hexabyte23/QuarkTx/README.md

# QuarkTx, up to 17 Channels !!



Radio Control system based on Arduino Nano ATmega 328  16 Mhz or Teensy 3.2 96 Mhz, with a simple aim: Provide the most powerfull embedded functions in the smalest piece of hardware.

## Doc
Radio [user guide](https://github.com/hexabyte23/QuarkTx/blob/master/Doc/radio.md)

Gui [user guide](https://github.com/hexabyte23/QuarkTx/blob/master/Doc/gui.md)

## Gui dir
Qt client source code for WIN 10, OSX, Android & IOS

## Radio dir
Arduino Nano ATmega328/Teensy 3.2 source code

## RF Module
Two RF modules has been successfully tested: Jeti TU2 2.4 GHz & FrSky DNT.

## RCL: a new language
We introduce RCL, a real time Radio Control Language, that include keywords for reverse, dual rate, exponetial and mixer functions per channel.

The average update rate of channels is more than 900 Hz for a 6 channels config with simple RCL commands.

## Lua

in beta test
