hexabyte23/QuarkTx/Lua/README.md

# Lua library
**Warning**: Only for Teensy 3.2 platform.

Copy of Lua 5.3.2 core functions, must be installed to Arduino IDE library directory :

_Win_: My Documents\Arduino\libraries\

_OSX_: ~/Documents/Arduino/libraries/
