hexabyte23/QuarkTx/Doc/help.pdf

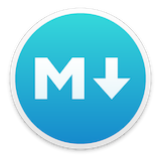
[picture p13: figure]

Hello there! I’m MacDown, the open source Markdown editor for OS X.

Let me introduce myself.

Markdown is a plain text formatting syntax created by John Gruber, aiming to provide a easy-to-read and feasible markup. The original Markdown syntax specification can be found here. (http://daringfireball.net/projects/markdown/syntax)

MacDown is created as a simple-to-use editor for Markdown documents. I render your Markdown contents real-time into HTML, and display them in a preview panel.

# MacDown

# Markdown and I

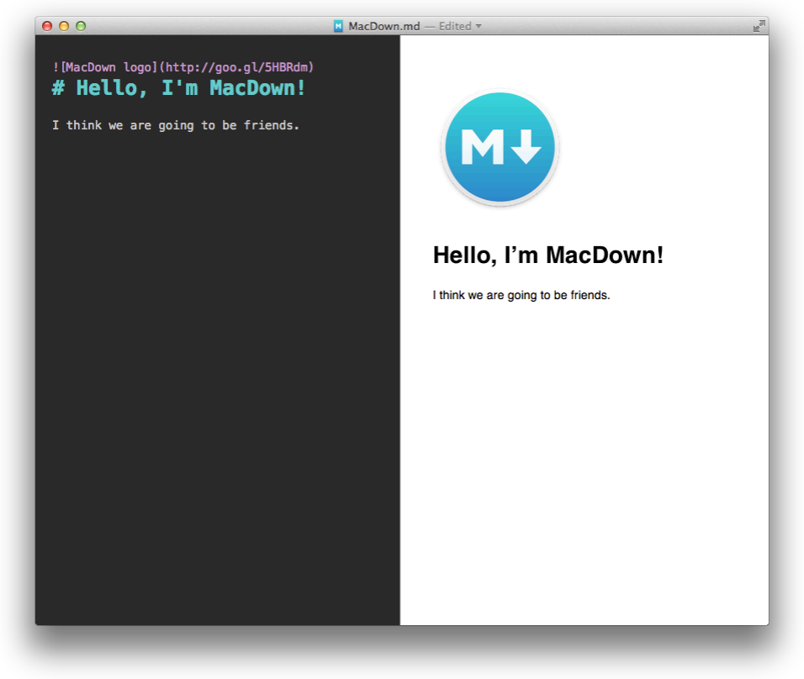
[picture p14: figure]

I support all the original Markdown syntaxes. But I can do so much more! Various popular but non-standard syntaxes can be turned on/off from the Markdown preference pane.

You can specify extra HTML rendering options through the Rendering preference pane.

You can customize the editor window to you liking in the Editor preferences pane:

You can configure various application (that's me!) behaviors in the General preference pane.

Before I tell you about all the extra syntaxes and capabilities I have, I'll introduce you to the basics of standard markdown. If you already know markdown, and want to jump straight to learning about the fancier things I can do, I suggest you skip to the Markdown preference pane. Lets jump right in.

# The Basics

## Line Breaks

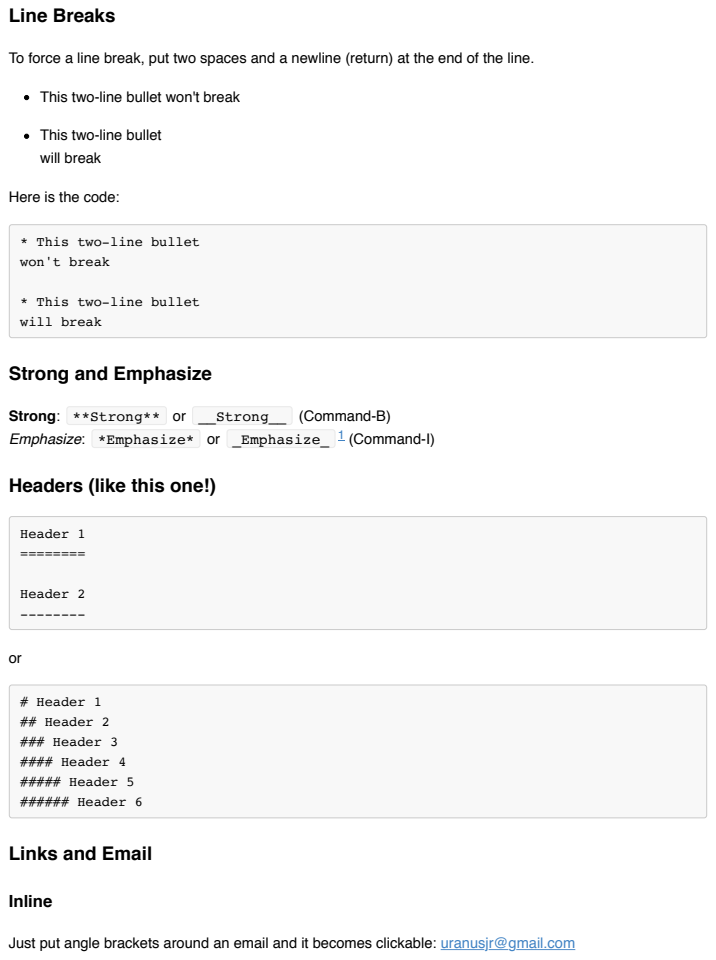
[picture p15: page 3]
Header 1 ========; Header 2 --------; # Header 1 ## Header 2 ### Header 3 #### Header 4 ##### Header 5 ###### Header 6; Inline

To force a line break, put two spaces and a newline (return) at the end of the line.

This two-line bullet won't break

This two-line bullet
will break

Here is the code:

* This two-line bullet
won't break

Strong and Emphasize

Strong: **Strong** or __Strong__ (Command-B)
Emphasize: *Emphasize* or _Emphasize_ 1 (Command-I)

Headers (like this one!)

Links and Email

Just put angle brackets around an email and it becomes clickable: uranusjr@gmail.com

<uranusjr@gmail.com>

Same thing with urls: http://macdown.uranusjr.com<http://macdown.uranusjr.com>

Perhaps you want to some link text like this: Macdown Website (http://macdown.uranusjr.com/)
[Macdown Website](http://macdown.uranusjr.com "Title") (The title is optional)

Sometimes it looks too messy to include big long urls inline, or you want to keep all your urls together.

Make a link (http://macdown.uranusjr.com/) [a link][arbitrary_id] then on it's own line anywhere else in the file: [arbitrary_id]: http://macdown.uranusjr.com "Title"

If the link text itself would make a good id, you can link like this (http://macdown.uranusjr.com/) [like this][] , then on it's own line anywhere else in the file:
[like this]: http://macdown.uranusjr.com

![Alt Image Text](path/or/url/to.jpg "Optional Title")

![Alt Image Text][image-id]
on it's own line elsewhere:
[image-id]: path/or/url/to.jpg "Optional Title"

Lists must be preceded by a blank line (or block element) Unordered lists start each item with a *
- works too

Indent a level to make a nested list
1. Ordered lists are supported.
2. Start each item (number-period-space) like 1.
3. It doesn't matter what number you use, I will render them sequentially
4. So you might want to start each line with 1. and let me sort it out

Here is the code:

### Reference style

## Images

### Inline

### Reference style

## Lists

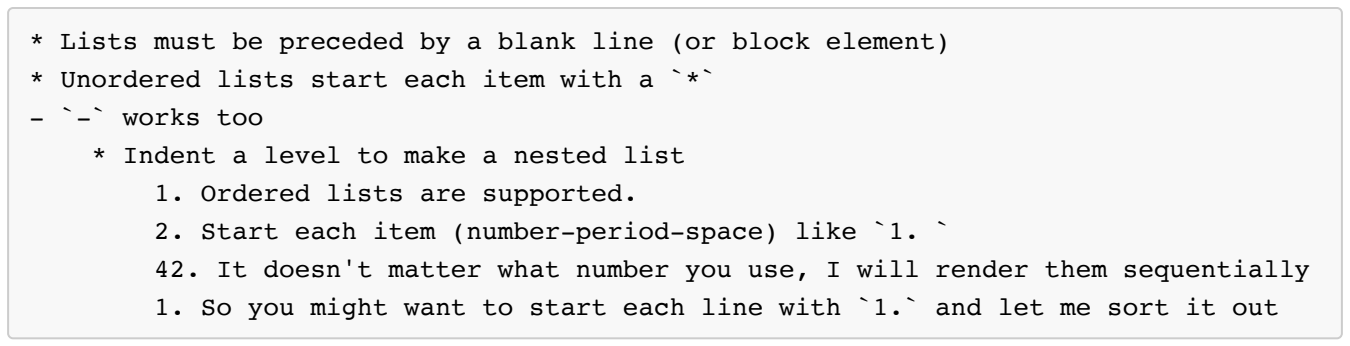
[picture p16: figure]
- `-` works too * Indent a level to make a nested list 1. Ordered lists are supported.

* Lists must be preceded by a blank line (or block element) * Unordered lists start each item with a `*`

2. Start each item (number-period-space) like `1. `
42. It doesn't matter what number you use, I will render them sequentially
1. So you might want to start each line with `1.` and let me sort it out

Angle brackets > are used for block quotes.
Technically not every line needs to start with a > as long as there are no empty lines between paragraphs.
Looks kinda ugly though.

Block quotes can be nested.

Multiple Levels

Most markdown syntaxes work inside block quotes.

Lists
Links (http://macdown.uranusjr.com/)
Etc.

Here is the code:

> Angle brackets `>` are used for block quotes.
Technically not every line needs to start with a `>` as long as there are no empty lines between paragraphs.
> Looks kinda ugly though.
> > Block quotes can be nested.
> > > Multiple Levels
>
> Most markdown syntaxes work inside block quotes. >
> * Lists
> * [Links][arbitrary_id]
> * Etc.

Inline code is indicated by surrounding it with backticks: `Inline code`

## Block Quote

## Inline Code

If your code has `backticks` that need to be displayed, you can use double backticks: ``Code with `backticks` `` (mind the spaces preceding the final set of backticks)

If you indent at least four spaces or one tab, I'll display a code block.

print('The block must be preceded by a blank line')
print('Then indent at least 4 spaces or 1 tab')
print('Nesting does nothing. Your code is displayed Literally')

I also know how to do something called Fenced Code Blocks which I will tell you about later.

If you type three asterisks *** or three dashes --- on a line, I'll display a horizontal rule:

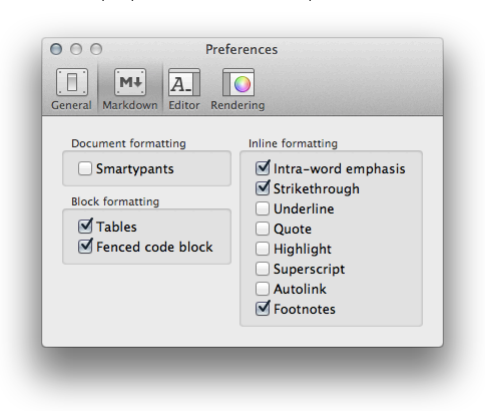
[picture p17: figure]

This is where I keep all preferences related to how I parse markdown into html.

## Block Code

## Horizontal Rules

# The Markdown Preference Pane

The Smartypants extension automatically transforms straight quotes ( " and ' ) in your text into typographer’s quotes ( “ , ” , ‘ , and ’ ) according to the context. Very useful if you’re a typography freak like I am. Quote and Smartypants are syntactically incompatible. If both are enabled, Quote takes precedence.

This is a table:

First Header | Second Header
Content Cell | Content Cell
Content Cell | Content Cell

You can align cell contents with syntax like this:

Left Aligned | Center Aligned | Right Aligned
col 3 is | some wordy text | $1600
col 2 is | centered | $12
zebra stripes | are neat | $1
The left- and right-most pipes ( | ) are only aesthetic, and can be omitted. The spaces don’t matter, either.
Alignment depends solely on : marks.

This is a fenced code block:

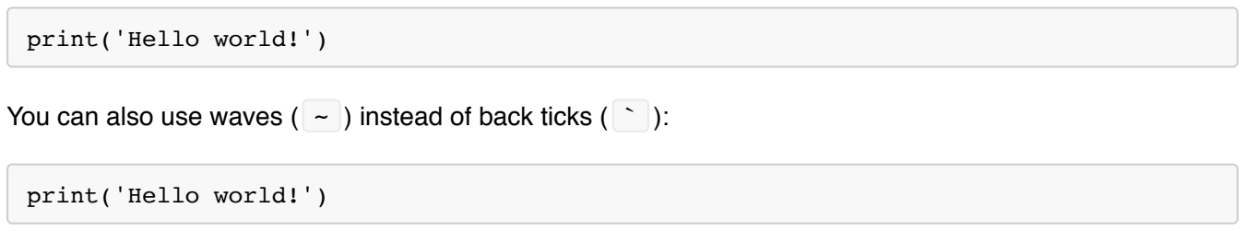
[picture p18: figure]
print('Hello world!')

You can also use waves ( ~ ) instead of back ticks ( ` ):

You can add an optional language ID at the end of the first line. The language ID will only be used to highlight the code inside if you tick the Enable highlighting in code blocks option. This is what happens if

## Document Formatting

## Block Formatting

### Table

### Fenced Code Block

you enable it:

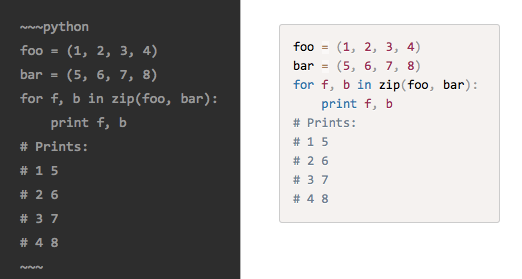
[picture p19: figure]

I support many popular languages as well as some generic syntax descriptions that can be used if your language of choice is not supported. See relevant sections on the official site (http://macdown.uranusjr.com/features/) for a full list of supported syntaxes.

The following is a list of optional inline markups supported:

Option name | Markup | Result if enabled
Intra-word emphasis | So A*maz*ing | So Amazing
Strikethrough | ~~Much wow~~ | Much wow
Underline 2 | _So doge_ | So doge
Quote 3 | "Such editor" | "Such editor"
Highlight | ==So good== | So good
Superscript | hoge^(fuga) | hogefuga
Autolink | http://t.co | http://t.co
Footnotes | [^4] and [^4]: | 4 and footnote 4

This is where I keep preferences relating to how I render and style the parsed markdown in the preview

## Inline Formatting

# The Rendering Preference Pane

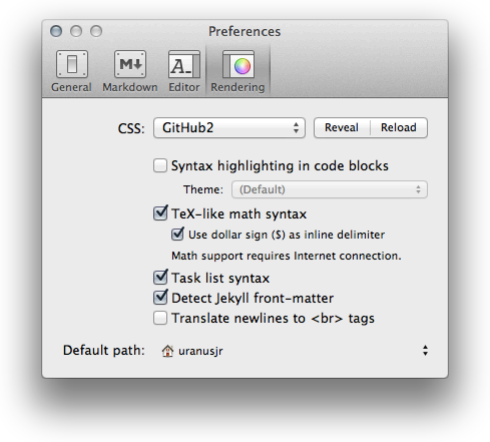
[picture p20: figure]

window.

You can choose different css files for me to use to render your html. You can even customize or add your own custom css files.

You have already seen how I can syntax highlight your fenced code blocks. See the Fenced Code Block section if you haven’t! You can also choose different themes for syntax highlighting.

I can also render TeX-like math syntaxes, if you allow me to.⁵ I can do inline math like this: \( 1 + 1 \) or this (in MathML): 1 + 1, and block math:

\[ A^T_S = B \]

or (in MathML)

## CSS

## Syntax Highlighting

## TeX-like Math Syntax

AS

T = B

1. [x] I can render checkbox list syntax [x] I support nesting
[x] I support ordered and unordered lists
2. [ ] I don't support clicking checkboxes directly in the html window

If you like, I can display Jekyll front-matter in a nice table. Just make sure you put the front-matter at the

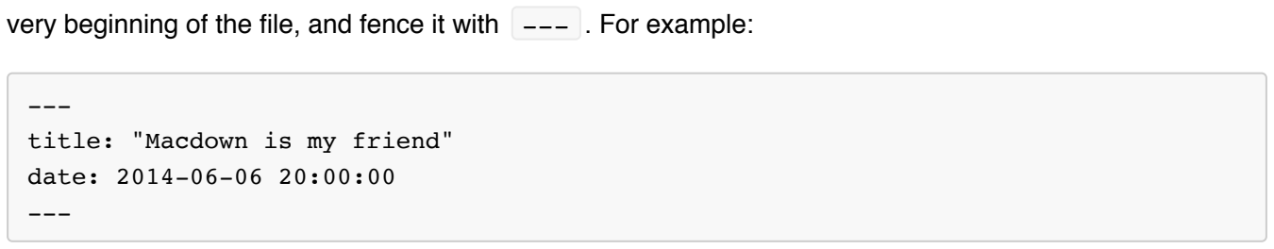
[picture p21: figure]
--- title: "Macdown is my friend" date: 2014-06-06 20:00:00 ---

very beginning of the file, and fence it with --- . For example:

Normally I require you to put two spaces and a newline (aka return) at the end of a line in order to create a line break. If you like, I can render a newline any time you end a line with a newline. However, if you enable this, markdown that looks lovely when I render it might look pretty funky when you let some other program render it.

This is where I keep preferences related to application behavior.

## Task List Syntax

## Jekyll front-matter

## Render newline literally

# The General Preferences Pane

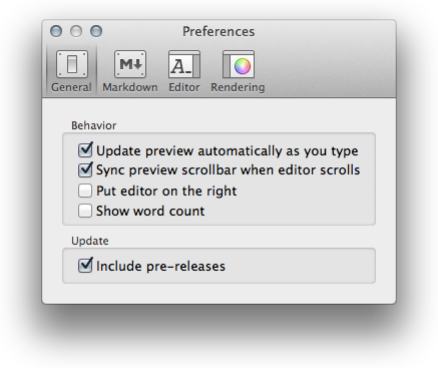
[picture p22: figure]

The General Preferences Pane allows you to tell me how you want me to behave. For example, do you want me to make sure there is a document open when I launch? You can also tell me if I should constantly update the preview window as you type, or wait for you to hit command-R instead. Maybe you prefer your editor window on the right? Or to see the word-count as you type. This is also the place to tell me if you are interested in pre-releases of me, or just want to stick to better-tested official releases.

This is where I keep preferences related to the behavior and styling of the editing window.

# The Editor Preference Pane

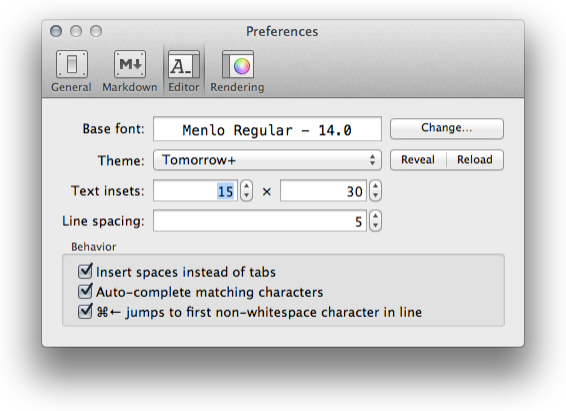
[picture p23: figure]

My editor provides syntax highlighting. You can edit the base font and the coloring/sizing theme. I provided some default themes (courtesy of Mou’s (http://mouapp.com/) creator, Chen Luo) if you don’t know where to start.

You can also edit, or even add new themes if you want to! Just click the Reveal button, and start moving things around. Remember to use the correct file extension ( .styles ), though. I’m picky about that.

I offer auto-completion and other functions to ease your editing experience. If you don’t like it, however, you can turn them off.

That’s about it. Thanks for listening. I’ll be quiet from now on (unless there’s an update about the app—I’ll remind you for that!).

Happy writing!

1. If Underlines is turned on, _this notation_ will render as underlined instead of emphasized ↩
2. If Underline is disabled _this_ will be rendered as emphasized instead of being underlined. ↩

## Styling

# Hack On

3. Quote replaces literal " characters with html <q> tags. Quote and Smartypants are syntactically incompatible. If both are enabled, Quote takes precedence. Note that Quote is different from blockquote, which is part of standard Markdown. ↩
4. You don't have to use a number. Arbitrary things like [^footy note4] and [^footy note4]: will also work. But they will render as numbered footnotes. Also, no need to keep your footnotes in order, I will sort out the order for you so they appear in the same order they were referenced in the text body. You can even keep some footnotes near where you referenced them, and collect others at the bottom of the file in the traditional place for footnotes. ↩
5. Internet connection required. ↩
