hexabyte23/QuarkTx/Artwork/QuarkTx 2.png

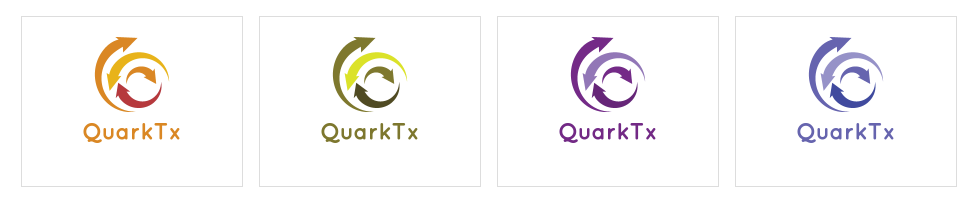
Artwork/QuarkTx 2.png
