hexabyte23/QuarkTx/Artwork/QuarkTx 3.png

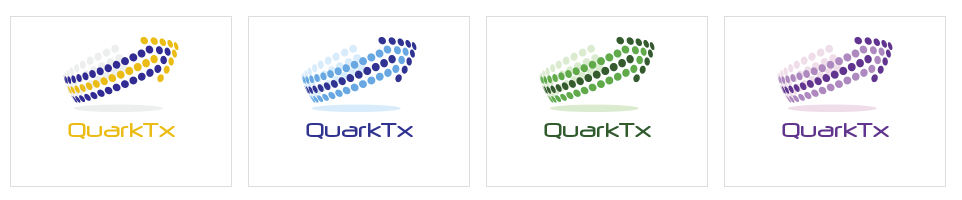
Artwork/QuarkTx 3.png
