hexabyte23/QuarkTx/Artwork/QuarkTx 4.png

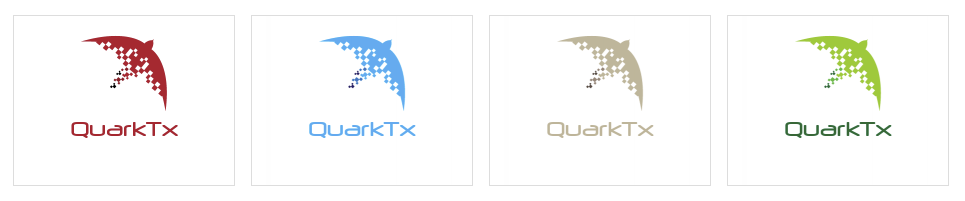
Artwork/QuarkTx 4.png
