hexabyte23/QuarkTx/Artwork/QuarkTx 5.png

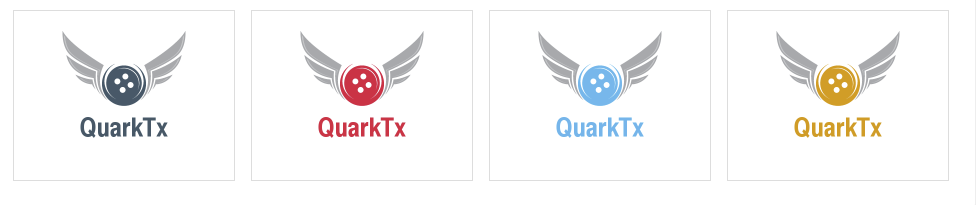
Artwork/QuarkTx 5.png
