hexabyte23/QuarkTx/(threads)

Thread 1 (2015-12-13):

Save sensor calibration result into EEPROM

hexabyte23, 2015-12-13:

hexabyte23, 2015-12-22:
fix done

Closed 2015-12-22.

Thread 2 (2015-12-30):

Bluetooth com unstable

hexabyte23, 2015-12-30:
On Arduino Nano there is only one physical serial port handle by UART.

For conveniant way, we try implement another serial com for bluetooth with SoftwareSerial, but this lib clears interrupt during write() and so make PPM signal glitch...
