hexabyte23/QuarkTx/Radio/Radio.ino

/*
Radio.ino - QuarkTx
Copyright (c) 2015-2018 Thierry & Bertrand WILMOT.  All rights reserved.

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
You should have received a copy of the GNU Lesser General Public
License along with this library; if not, write to the Free Software
Foundation, Inc., 51 Franklin St, Fifth Floor, Boston, MA  02110-1301  USA
*/

#include "Tx.h"

Tx tx;

void setup()
{
  tx.setup();
}

#ifdef QUARKTX_TEENSY
void pit1_isr()
#else
ISR(TIMER1_COMPA_vect)
#endif
{
   tx.onIsrTimerChange();
}


void loop()
{   
   tx.loop();
}
