hexabyte23/QuarkTx/Radio/Sensor.h

/*
Sensor.h - QuarkTx
Copyright (c) 2015-2018 Thierry & Bertrand WILMOT.  All rights reserved.

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
You should have received a copy of the GNU Lesser General Public
License along with this library; if not, write to the Free Software
Foundation, Inc., 51 Franklin St, Fifth Floor, Boston, MA  02110-1301  USA
*/

#ifndef SENSOR_H
#define SENSOR_H

#include <inttypes.h>
#include "config.h"
#ifdef QUARKTX_TEENSY
#include <ArduinoJson.h>
#endif

class Sensor
{
protected:

   uint8_t pin_;
   uint16_t calibrMin_;
   uint16_t calibrMax_;
   int trim_;

   void calibration(uint16_t val);

public:

   Sensor();

   uint8_t getPin() const {return pin_;}
   uint16_t getMinCalibration() const {return calibrMin_;}
   uint16_t getMaxCalibration() const {return calibrMax_;}
   void setTrim(int trim) {trim_ = trim;}
   void setMin(uint16_t calibrMin) {calibrMin_ = calibrMin;}
   void setMax(uint16_t calibrMax) {calibrMax_ = calibrMax;}
   int getTrim() const {return trim_;}

   virtual void dump() const;

   virtual void setup(uint8_t pin) = 0;
   virtual void calibrate() = 0;
   virtual uint16_t getValue() const = 0;
#ifdef QUARKTX_TEENSY
   virtual void saveToJSon(DynamicJsonBuffer &buf) const;
   virtual void loadFfromJSon(const DynamicJsonBuffer &buf);
#endif
   virtual void saveToEEPROM(uint16_t &addr) const;
   virtual void loadFromEEPROM(uint16_t &addr);
   virtual void reset();
};

class Stick : public Sensor
{
public:

   Stick();

   virtual void setup(uint8_t pin);
   virtual void calibrate();
   virtual uint16_t getValue() const;
};

class Switch : public Sensor
{
   void debounce();

public:

   Switch();

   virtual void setup(uint8_t pin);
   virtual void calibrate();
   virtual uint16_t getValue() const;
};

class BatteryMeter : public Sensor
{
   float levelSum_;
   float histoLevel_[BATTERY_HISTO_BUFFER_SIZE];
   uint16_t currentHistoIdx_, oldestHistoIdx_;
   float lastValue_;

   float computeAverageValueInVolt();

public:
   
   BatteryMeter();

   virtual void setup(uint8_t pin);
   virtual void calibrate() {}
   virtual uint16_t getValue() const;
   virtual void reset();
   
   float getValueInVolt() const;
   float getLastAverageValueInVolt() const {return lastValue_;}
   bool isLevelTooLow();
};

class Gyroscope : public Sensor
{
public:

   Gyroscope() {}

   virtual void setup(uint8_t pin);
   virtual void calibrate();
   virtual uint16_t getValue() const;
};

#endif
