hexabyte23/QuarkTx/Radio/Model.cpp

/*
Model.cpp - QuarkTx
Copyright (c) 2015-2018 Thierry & Bertrand WILMOT.  All rights reserved.

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
You should have received a copy of the GNU Lesser General Public
License along with this library; if not, write to the Free Software
Foundation, Inc., 51 Franklin St, Fifth Floor, Boston, MA  02110-1301  USA
*/

#include <arduino.h>
#include <EEPROM.h>
#include "Model.h"
#include "SerialLink.h"

//////////////////////////////////////////////////////////////

ServoCommand::ServoCommand()
{
   reset();
}

uint16_t ServoCommand::getValue(uint16_t rawInputValue) const
{
   uint16_t ret = map(rawInputValue, QUARKTX_ADC_MIN_VALUE, QUARKTX_ADC_MAX_VALUE, isRevert_?maxOutCurse_:minOutCurse_, isRevert_?minOutCurse_:maxOutCurse_) + neutral_;

   // apply PPM bound limitations
   if(ret > QUARKTX_PPM_MAX_VALUE)
      ret = QUARKTX_PPM_MAX_VALUE;
   if(ret < QUARKTX_PPM_MIN_VALUE)
      ret = QUARKTX_PPM_MIN_VALUE;

   return ret;
}

void ServoCommand::reset()
{
   maxOutCurse_ = QUARKTX_PPM_MAX_VALUE;
   minOutCurse_ = QUARKTX_PPM_MIN_VALUE;
   neutral_ = 0;
   isRevert_ = false;
}

void ServoCommand::saveToEEPROM(uint16_t &addr) const
{
   EEPROM.put(addr, maxOutCurse_);
   addr += sizeof(uint16_t);
   EEPROM.put(addr, minOutCurse_);
   addr += sizeof(uint16_t);
   EEPROM.put(addr, neutral_);
   addr += sizeof(int16_t);
   EEPROM.put(addr, isRevert_);
   addr += sizeof(bool);
}

void ServoCommand::loadFromEEPROM(uint16_t &addr)
{
   EEPROM.get(addr, maxOutCurse_);
   addr += sizeof(uint16_t);
   EEPROM.get(addr, minOutCurse_);
   addr += sizeof(uint16_t);
   EEPROM.get(addr, neutral_);
   addr += sizeof(int16_t);
   EEPROM.get(addr, isRevert_);
   addr += sizeof(bool);
}

//////////////////////////////////////////////////////////////

void OutputChannel::saveToEEPROM(uint16_t &addr) const
{
   servo_.saveToEEPROM(addr);
}

void OutputChannel::loadFromEEPROM(uint16_t &addr)
{
   servo_.loadFromEEPROM(addr);
}

//////////////////////////////////////////////////////////////

Model::Model()
{
}

bool Model::setup()
{
   return true;
}

uint16_t Model::getValue(uint8_t channel, uint16_t rawInputValue) const
{
   return channel_[channel].servo_.getValue(rawInputValue);
}

void Model::setMinValue(uint8_t channel, int value)
{
   channel_[channel].servo_.minOutCurse_ = value;
}

void Model::setMaxValue(uint8_t channel, int value)
{
   channel_[channel].servo_.maxOutCurse_ = value;
}

void Model::setNeutralValue(uint8_t channel, uint16_t value)
{
   channel_[channel].servo_.neutral_ = value;
}

void Model::setRevertValue(uint8_t channel, bool value)
{
   channel_[channel].servo_.isRevert_ = value;
}

void Model::dump()
{
#ifndef QUARKTX_TEST
   STDOUT << F("Servo\n# Min   Max   Neutral   Rev") << endl;

   for(int idx=0; idx < QUARKTX_MAX_PPM_OUTPUT_CHANNEL; idx++)
   {
      STDOUT << idx << " " << channel_[idx].servo_.minOutCurse_ << "\t" <<
                channel_[idx].servo_.maxOutCurse_ << "\t" <<
                channel_[idx].servo_.neutral_ << "\t" <<
                channel_[idx].servo_.isRevert_ << endl;
   }
#endif
}

void Model::reset()
{
   for(int idx=0; idx < QUARKTX_MAX_PPM_OUTPUT_CHANNEL; idx++)
      channel_[idx].servo_.reset();
}

void Model::saveToEEPROM(uint16_t &addr) const
{
   for(uint8_t idx=0; idx < QUARKTX_MAX_PPM_OUTPUT_CHANNEL; idx++)
      channel_[idx].saveToEEPROM(addr);
}

void Model::loadFromEEPROM(uint16_t &addr)
{
   for(uint8_t idx=0; idx < QUARKTX_MAX_PPM_OUTPUT_CHANNEL; idx++)
      channel_[idx].loadFromEEPROM(addr);

}
