hexabyte23/QuarkTx/Gui/src/main.cpp

/*
Command.cpp - QuarkTx
Copyright (c) 2015-2016 Thierry & Betrand WILMOT.  All rights reserved.

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
You should have received a copy of the GNU Lesser General Public
License along with this library; if not, write to the Free Software
Foundation, Inc., 51 Franklin St, Fifth Floor, Boston, MA  02110-1301  USA
*/


#include "src/main.h"
#include "src/global.h"
#include "src/BatteryModel.h"
#include "src/MainModel.h"
#include "src/RclMainWindow.h"


Q_LOGGING_CATEGORY(QUARKTX_MAIN, "quarktx.main")

static MainModel g_model;

void myMessageOutput(QtMsgType type, const QMessageLogContext &context, const QString &msg)
{
   QByteArray localMsg = msg.toLocal8Bit();
   const char* time = QTime::currentTime().toString("hh:mm:ss.zzz").toStdString().c_str();
#ifdef QT_DEBUG
   switch (type)
   {
      case QtInfoMsg:
         fprintf(stderr, "%s [I] %s (%s:%u, %s)\n", time, localMsg.constData(), context.file, context.line, context.function);
         break;
      case QtDebugMsg:
         fprintf(stderr, "%s [D] %s (%s:%u, %s)\n", time, localMsg.constData(), context.file, context.line, context.function);
         break;
      case QtWarningMsg:
         fprintf(stderr, "%s [W] %s (%s:%u, %s)\n", time, localMsg.constData(), context.file, context.line, context.function);
         break;
      case QtCriticalMsg:
         fprintf(stderr, "%s [C] %s (%s:%u, %s)\n", time, localMsg.constData(), context.file, context.line, context.function);
         break;
      case QtFatalMsg:
         fprintf(stderr, "%s [F] %s (%s:%u, %s)\n", time, localMsg.constData(), context.file, context.line, context.function);
         abort();
   }
#else
   switch (type)
   {
      case QtInfoMsg:
         fprintf(stderr, "%s [I] %s\n", time, localMsg.constData());
         break;
      case QtDebugMsg:
         break;
      case QtWarningMsg:
         fprintf(stderr, "%s [W] %s\n", time, localMsg.constData());
         break;
      case QtCriticalMsg:
         fprintf(stderr, "%s [C] %s\n", time, localMsg.constData());
         break;
      case QtFatalMsg:
         fprintf(stderr, "%s [F] %s\n", time, localMsg.constData());
         abort();
   }
#endif
}

void Init(const QApplication &app)
{
   qInstallMessageHandler(myMessageOutput);

   QLoggingCategory::setFilterRules(QStringLiteral("quarktx.main=true"));
   QLoggingCategory::setFilterRules(QStringLiteral("*.link=false"));
   QLoggingCategory::setFilterRules(QStringLiteral("quarktx.link.command=true"));

   //app.setFont(QFont("courrier"));
   app.setApplicationName(APP_NAME);
   app.setApplicationVersion(APP_VERSION);
   qCInfo(QUARKTX_MAIN) << "Starting " APP_NAME << APP_VERSION;
}

int main(int argc, char *argv[])
{
   QApplication app(argc, argv);

   Init(app);

   QTranslator qtTranslator;
   QString filename = "QuarkTx_" + QLocale::system().name() + ".qm";
   QString path = ":/";

   // For updating QUARKTX_xx_XX.qm use menu
   // Tools/Extern/linguist/update & lrelease

   if(qtTranslator.load(filename, path) == false)
   {
      QString msg = "'" + path + filename + "' not found";
      qCDebug(QUARKTX_MAIN) << msg;
   }
   else
      app.installTranslator(&qtTranslator);

   QQmlApplicationEngine engine;
   g_model.init(engine.rootContext());
//   engine.load(QUrl(QStringLiteral("qrc:/qml/main.qml")));

   RclMainWindow w;
   w.show();

   int ret = app.exec();

   qCInfo(QUARKTX_MAIN) << "Ending " APP_NAME << APP_VERSION;

   return ret;
}
