hexabyte23/QuarkTx/Gui/src/RadioLink.cpp

/*
Command.cpp - QuarkTx
Copyright (c) 2015-2016 Thierry & Betrand WILMOT.  All rights reserved.

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
You should have received a copy of the GNU Lesser General Public
License along with this library; if not, write to the Free Software
Foundation, Inc., 51 Franklin St, Fifth Floor, Boston, MA  02110-1301  USA
*/

#include "RadioLink.h"
//#include <QThread>

Q_LOGGING_CATEGORY(QUARKTX_LINK_SERIAL, "quarktx.link.serial")
Q_LOGGING_CATEGORY(QUARKTX_LINK_BT, "quarktx.link.bt")

RadioLink::RadioLink()
   :
     isTxConnected_(false),
     transportStatusStr("No transport"),
     cnxStatusStr_("Not connected"),
     txVersionStr_("NA")
#if defined(Q_OS_MAC) || defined(Q_OS_WIN)
     ,serialPort_(NULL),
     serialPortInfo_(NULL)
#endif
{
}

RadioLink::~RadioLink()
{
   closeSerialLink();
   closeBlueToothLink();
}

void RadioLink::closeSerialLink()
{
#if defined(Q_OS_MAC) || defined(Q_OS_WIN)

   if(serialPort_)
   {
      if(serialPort_->isOpen())
         serialPort_->close();
      disconnect(serialPort_, SIGNAL(readyRead()), this, SLOT(serialPortReadyRead()));
      disconnect(serialPort_, SIGNAL(error(QSerialPort::SerialPortError)), this,
                 SLOT(serialPortHandleError(QSerialPort::SerialPortError)));

      delete serialPort_;
      serialPort_ = NULL;

      QSerialPortInfo i;
      serialPortInfo_ = i;
   }
#endif
}

void RadioLink::closeBlueToothLink()
{
}

bool RadioLink::searchForSerialLink()
{
#if defined(Q_OS_MAC) || defined(Q_OS_WIN)

   bool foundCnx = false;
   output_.clear();

   QList<QSerialPortInfo> serialPortInfoList = QSerialPortInfo::availablePorts();
   for (int i = 0; i < serialPortInfoList.size(); i++)
   {
      const QSerialPortInfo &serialPortInfo = serialPortInfoList[i];
      serialPort_ = new QSerialPort(serialPortInfo, this);
      connect(serialPort_, SIGNAL(readyRead()), this, SLOT(serialPortReadyRead()));
      connect(serialPort_, SIGNAL(error(QSerialPort::SerialPortError)), this,
              SLOT(serialPortHandleError(QSerialPort::SerialPortError)));

      qCDebug(QUARKTX_LINK_SERIAL) << "Try open cnx: " << serialPortInfo.portName();

      if(serialPort_->open(QIODevice::ReadWrite))
      {
         qCDebug(QUARKTX_LINK_SERIAL) << "Waiting for anwser...";

         if(serialPort_->waitForReadyRead(QUARKTX_MIN_WAIT_DEVICE))
         {
            qCDebug(QUARKTX_LINK_SERIAL) << "Anwsering... Check if QuarkTx device";

            QString line = getNextLine();
            qCDebug(QUARKTX_LINK_SERIAL) << "Answer is:" << line;

            if(line.startsWith("Quark Tx v"))
            {
               qCDebug(QUARKTX_LINK_SERIAL) << "QuarkTx device detected " << txVersionStr_;

               txVersionStr_ = line.mid(sizeof("Quark Tx v")-1);
               foundCnx = true;
               serialPortInfo_ = serialPortInfo;
               break;
            }
            else
               qCWarning(QUARKTX_LINK_SERIAL) << "Not a QuartTx device";
         }
         else
            qCDebug(QUARKTX_LINK_SERIAL) << "Device not anwsering since 3 sec";

         qCDebug(QUARKTX_LINK_SERIAL) << "Close cnx: " << serialPortInfo.portName();
         closeSerialLink();
      }
      else
      {
         qCWarning(QUARKTX_LINK_SERIAL) << "Fail to open: " << serialPortInfo.portName();
      }
   }

   if(!foundCnx)
   {
      qCWarning(QUARKTX_LINK_SERIAL) << "No QuarkTx device found on serial link";
      return false;
   }

   isTxConnected_ = true;
   transportStatusStr = "Serial link";
   cnxStatusStr_ = serialPortInfo_.portName();

   output_.clear();

   return true;
#else
   return false;
#endif
}

bool RadioLink::searchForBlueToothLink()
{
   return false;
}

void RadioLink::init()
{
}

bool RadioLink::writeData(const QByteArray &data)
{
#if defined(Q_OS_MAC) || defined(Q_OS_WIN)
   if(serialPort_ == NULL)
   {
      qCWarning(QUARKTX_LINK_SERIAL) << "Cnx not established";
      return false;
   }

   input_ = data;
   if(serialPort_->write(data) != -1)
   {
      qCDebug(QUARKTX_LINK_SERIAL) << "< " << data;
      return true;
   }
#endif

   return false;
}

const QByteArray RadioLink::readData()
{
   QByteArray ret;

#if defined(Q_OS_MAC) || defined(Q_OS_WIN)
   if(serialPort_ == NULL)
   {
      qCWarning(QUARKTX_LINK_SERIAL) << "Cnx not established";
      return ret;
   }

   ret = serialPort_->readAll();
   if(ret[0] == '\0')
      ret.remove(0, 1);

   output_ += ret;
#endif

   return ret;
}


// QML functions

bool RadioLink::findTxAndConnect()
{ 
   if(!searchForSerialLink())
   {
      if(!searchForBlueToothLink())
      {
         qCWarning(QUARKTX_LINK_SERIAL) << "No device found";
         return false;
      }
   }

   return true;
}

void RadioLink::txDisconnect()
{
   closeSerialLink();
   closeBlueToothLink();

   isTxConnected_ = false;
   transportStatusStr = "No transport";
   cnxStatusStr_ = "Not connected";
   txVersionStr_ = "NA";

   qCDebug(QUARKTX_LINK_SERIAL) << "Disconnect Tx";
}

QString RadioLink::getNextLine()
{
   QString ret;

#if defined(Q_OS_MAC) || defined(Q_OS_WIN)
   if(serialPort_ == NULL)
   {
      qCWarning(QUARKTX_LINK_SERIAL) << "Cnx not established";
      return ret;
   }

   while(1)
   {
      if(output_.isEmpty())
         serialPort_->waitForReadyRead(-1);

      char c = output_[0];
      output_.remove(0,1);

      if(c == '\r')
         continue;
      else if(c == '\n')
         break;

      ret.append(c);
   }
#endif

   return ret;
}

bool RadioLink::sendCommand(const QString &cmd)
{
   output_.clear();
   return writeData(cmd.toLatin1());
}

// Callbacks

#if defined(Q_OS_MAC) || defined(Q_OS_WIN)

void RadioLink::serialPortReadyRead()
{
   qCDebug(QUARKTX_LINK_SERIAL) << "> " << readData();
}

void RadioLink::serialPortHandleError(QSerialPort::SerialPortError error)
{
   if(serialPort_ == NULL)
   {
      qCWarning(QUARKTX_LINK_SERIAL) << "Cnx not established";
      return;
   }

   if(error != QSerialPort::NoError)
   {
      cnxStatusStr_ = serialPort_->errorString();
      transportStatusStr = "Error";

      qCWarning(QUARKTX_LINK_SERIAL) << "Cnx error: '" << error << "' " << cnxStatusStr_;
   }
}

#endif
