hexabyte23/QuarkTx/Gui/src/TxCommand.cpp

/*
Command.cpp - QuarkTx
Copyright (c) 2015-2016 Thierry & Betrand WILMOT.  All rights reserved.

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
You should have received a copy of the GNU Lesser General Public
License along with this library; if not, write to the Free Software
Foundation, Inc., 51 Franklin St, Fifth Floor, Boston, MA  02110-1301  USA
*/

#include "TxCommand.h"

Q_LOGGING_CATEGORY(QUARKTX_LINK_COMMAND, "quarktx.link.command")

TxCommand::TxCommand()
   :
     radioLinkRef_(NULL),
     refreshSensorCache_(true)
{

}

TxCommand::~TxCommand()
{

}

void TxCommand::init(RadioLink *radioLinkRef)
{
   radioLinkRef_ = radioLinkRef;
}

bool TxCommand::sendCommand(const QString &cmd)
{
   if(radioLinkRef_ == NULL)
   {
      qCWarning(QUARKTX_LINK_COMMAND) << "radioLinkRef is NULL";
      return false;
   }
   return radioLinkRef_->sendCommand(cmd);
}

QString TxCommand::getNextLine()
{
   QString ret = "NA";

   if(radioLinkRef_ == NULL)
   {
      qCWarning(QUARKTX_LINK_COMMAND) << "radioLinkRef is NULL";
      return "";
   }

   ret = radioLinkRef_->getNextLine();

   return ret;
}

QString TxCommand::getFreeMemoryStr()
{
   QString ret = "NA";

   if(sendCommand(TX_CMD_FREE_MEMORY))
      ret = getNextLine();

   return ret;
}

bool TxCommand::fillSensorCache()
{
   bool ret = sendCommand("d s\r");
   if (ret == false)
      return false;

   sensorCache_.clear();
   qCDebug(QUARKTX_LINK_COMMAND) << "FillSensorCache";

   QString line;
   while(!line.startsWith("Dump"))
      line= getNextLine();          // Dump
   line = getNextLine();            // Sensors(xx)
   line = getNextLine();            // #pin #trim

   sensorCache_.push_back(getNextLine()); // #0
   sensorCache_.push_back(getNextLine()); // #1
   sensorCache_.push_back(getNextLine()); // #2
   sensorCache_.push_back(getNextLine()); // #3
   sensorCache_.push_back(getNextLine()); // #4
   sensorCache_.push_back(getNextLine()); // #5
   sensorCache_.push_back(getNextLine()); // #6

   refreshSensorCache_ = false;

   return true;
}

QVariantMap TxCommand::getSensorData(int sensorID)
{
   QVariantMap map;

   if(sensorCache_.isEmpty() || refreshSensorCache_)
   {
      if(!fillSensorCache())
         return map;
   }

   QString line = sensorCache_[sensorID];

   QStringList l = line.split("\t");
   qCDebug(QUARKTX_LINK_COMMAND) << l;

   if(l.size() < 4)
   {
      qWarning() << "Bad sensor cache format";
      return map;
   }
   map.insert("trim", l[1].toInt());
   map.insert("min", l[2].toInt());
   map.insert("max", l[3].toInt());
   map.insert("sim", l[4].toInt());

   return map;
}

void TxCommand::setSensorData(int sensorID, QVariantMap data)
{
   if(data.contains("trim"))
      sendCommand(QString("s t %1 %2\r").arg(sensorID).arg(data["trim"].toInt()));

   if(data.contains("min"))
      sendCommand(QString("s i %1 %2\r").arg(sensorID).arg(data["min"].toInt()));

   if(data.contains("max"))
      sendCommand(QString("s a %1 %2\r").arg(sensorID).arg(data["max"].toInt()));

   refreshSensorCache_ = true;
}
