hexabyte23/QuarkTx/(commit log)

2015-12-11 add new reset command
    [Command.cpp, Command.h, Model.cpp, Model.h, Tx.cpp, Tx.h, config.h]
2015-12-11 fix bound limit value problem
    [Model.cpp]
2015-12-12 fix out of bound error
    [Tx.cpp]
2015-12-12 bug fix when ADC scanned by IRQ
    [Tx.cpp, Tx.h]
2015-12-12 add calibration for ADC input sensors
2015-12-12 fix memory problem when display usage
    [Command.cpp, Tx.cpp]
2015-12-12 add calibrate section to dump command
2015-12-12 remove ADC IRQ function
2015-12-12 add 2 digital input sensors from pin 11 & 12
2015-12-12 led blinking
2015-12-13 introduce Sensor class
2015-12-14 Fix bugs on switches
    [Sensor.cpp, config.h]
2015-12-19 partial fix Rl class
    [Tx.cpp]
2015-12-20 fix Radio Language issue
    [Model.cpp, Model.h, Sensor.cpp, Sensor.h, Tx.cpp]
2015-12-22 big refactoring
    - recode from scratch RadioLangugage classes
    - introduce new device TerraTop
    - add a new simulateSensor for Unit testings
    - refactor irq variables
2015-12-24 add comment about Interrupt also simplify
2015-12-25 fix PPM bug for channel 1
    [Tx.cpp, config.h]
2015-12-27 modify static sensorExp variable to tab
2015-12-30 fix dump display when value <= 9
    [Tx.cpp]
2015-12-30 add more option on reset and dump commands
    [Command.cpp, Command.h, Evaluator.cpp, Evaluator.h, Tx.cpp, Tx.h]
2015-12-31 bug fix in parseNumeric + add some expo
    [Evaluator.cpp, Evaluator.h, Tx.cpp]
2015-12-31 add SubExpression and > and < operation
    fix a ? bug
    [Evaluator.cpp, Evaluator.h, Tx.cpp, config.h]
2016-01-03 replace old way to store in PROGRAM
    free 240 Bytes
    [Command.cpp, Evaluator.cpp, Evaluator.h, Model.cpp, Sensor.cpp, SerialLink.cpp, Tx.cpp, Tx.h]
2016-01-10 fix dump bad format
    [Tx.cpp]
2016-01-10 fix format display on dump
    [Tx.cpp]
2016-01-16 beautifier code + fix RLC EEPROM save
    [Command.cpp, Command.h, MemoryFree.cpp, Mesure.cpp, Mesure.h, Model.cpp, Model.h, RCLEval.cpp]
2016-01-16 fix Print class + add first tests
    [main.cpp]
2016-01-16 fix RCL save to EEPROM
    [RCLEval.cpp]
2016-01-16 add 2 new sensor functions
2016-01-17 add page sensor trim, min max
2016-01-23 Teensy 3.2 compatibility
2016-01-24 adapt code to teensy 3.2
2016-01-24 fist usable version with teensy 3.2
2016-01-24 fix PPM generate freeze since 2 min after reboot
    [Tx.cpp]
2016-01-25 add freeMemory for teensy 3.2
2016-01-30 fix bug when MAX_INPUT_CHANNEL < MAX_PPM_OUTPUT_CHANNEL
    [Tx.cpp]
2016-01-30 fix bug on number of serial port scan
    [RadioLink.cpp]
2016-01-30 Add a delay on teensy for make serial working (bug?)
    [SerialLink.cpp]
2016-01-30 dont care about disturb, as all files ares insert into RC
2016-01-30 fix cox when first device reboot
    [RadioLink.cpp]
2016-01-30 Add logging category + make android compile error free
    [RadioLink.cpp, TxCommand.cpp, global.h, main.cpp]
2016-01-31 remove named sensors
2016-01-31 fix change current model bug (forget change tcl ptr)
    [Model.h, RCLEval.h, Tx.cpp]
2016-01-31 clean switch warning on modern compiler
2016-01-31 fix freeze in debug mode
    [RCLEval.cpp, RCLEval.h, Tx.cpp]
2016-02-06 refactoring
    add 2 define to handle Arduino/Teensy hardware config
    add extra message when load from EEPROM
2016-02-07 Remove simulation code, get some space free for Arduino board
    Find a best way to provide Unit Test code by overload analogRead()
2016-02-14 Add battery alarm function
2016-02-15 add test for teensy
2016-02-19 add eagle schema & board
2016-02-22 remove bluetooth code using SoftwareSerial
    can’t work in Nano, cause SoftSerial use interrupt
2016-02-22 update doc
    commands and teensy eagle schema
2016-02-23 add battery meter calibration setting
2016-02-27 add capacity on 3v3, add 3v3 pin in SPI connector
2016-02-27 update pub for teensy
2016-02-27 Add batt level raise error
    [Sensor.cpp, Tx.cpp, Tx.h, config.h]
2016-02-27 refactoring
    rename idle() to loop()
    Clean class Tx dependance in RCLEval.cpp
    add EEPROM version tag to prevent data lost
    [MemoryFree.cpp, Model.h, RCLEval.cpp, RCLEval.h, Radio.ino, Sensor.cpp, SerialLink.cpp, SerialLink.h]
2016-02-27 refactoring
    transform loop turn to mill sec for batt level check period
    (independent to Nano or Teensy platform)
2016-02-27 Add new UUID command for teensy only
2016-02-27 Handle RC TX mode + fix display booting seq issue on Teensy
    [Command.cpp, Command.h, Radio.ino, Sensor.cpp, SerialLink.cpp, SerialLink.h, Tx.cpp, Tx.h]
2016-03-06 LED blink duration depend of primary or alt Serial binding
    [Command.cpp, Command.h, Fs.cpp, SerialLink.cpp, SerialLink.h, Tx.cpp, Tx.h, config.h]
2016-05-01 first opens cad version
    [quarkTx.scad]
2016-05-02 add gimbal support, modify switch dimension
    [quarkTx.scad]
2016-05-03 fix screw support Z, add holes in bottom
    [quarkTx.scad]
2016-05-08 refactoring + usb hole
    [quarkTx.scad]
2016-07-17 update screen version
    [quarkTx.scad]
2017-02-08 fix bad defines for making switches working
    [Tx.cpp]
2017-02-15 fix float error in division
    [Sensor.cpp]
2018-01-27 copyright update
    [Untitled.scad, quarkTx.scad, quarkTx1.scad, quarkTx2.scad, quarkTx3.scad]
